Picjavard/Katamaran_Model/README.md

# Радиоуправляемая Модель Катамарана/Лодки

> ⚠️ **Внимание!** Это описание проекта все еще редактируется и может измениться. По возникающим вопросам обращаться на почту picjavard@yandex.ru

**Проект лаборатории "Электроника", ВДЦ "Океан"**  
*Создано школьниками под руководством преподавателя*

Фото готовых моделей
[`Фото собранных моделей`](Фото/)

Проект по созданию радиоуправляемой модели катамарана (или лодки) с воздушным винтом и рулем. Модель построена школьниками на смене в ВДЦ "Океан" из доступных материалов (пеноплекс, ПВХ) с использованием базовых навыков пайки и конструирования.

**Особенности проекта:**
*   Самодельный корпус из пеноплекса
*   Воздушный движитель (пропеллер) и воздушный руль
*   Электроника на макетной плате с удобными коннекторами
*   Защита от брызг подручными средствами
*   Адаптивность: гонки можно провести как на воде, так и на суше!

## 📦 Необходимые Компоненты и Материалы
| Категория | Компонент/Материал | Кол-во | Примечание/Ссылка\* |
|---|---|---|---|
| **Корпус** | Пеноплекс (толщина 20-50мм), лист ~A3 | 1-2 | [Основа для поплавков/корпуса](https://www.vseinstrumenti.ru/product/ekstrudirovannyj-penopolistirol-penoplex-komfort-50x585x1185-mm-v-upakovke-7-sht-tu0-0001954-7207370/) |
| | Лист ПВХ (толщина 2-3мм), размер под корпус | 1 | [Палуба для крепления механизмов и электроники](https://www.ozon.ru/product/pvh-paneli-a3-5-shtuk-dlya-modelirovaniya-i-rukodeliya-plastik-listovoy-dlya-hobbi-i-tvorchestva-1718241610/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) |
| | Мачта-крепление двигателя | 1 | [Луч от рамы квадрокоптера модели F450](https://aliexpress.ru/item/961013343.html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)
| **Движитель** | Бесколлекторный мotor (например, 2212 1000KV) | 1 | [При выборе мотора, подбор пропеллера обезателен](https://www.ozon.ru/product/besshchetochnyy-dvigatel-a2212-13t-1000kv-s-testerom-servoprivodov-3-rezhima-servo-tester-2379004382/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) |
| | Пропеллер 12x6 или 10x4.7 (пластиковый) | 1 | Радиус ~12см, лучше брать в комплекте с мотором |
| | ESC (Electronic Speed Controller) 20-30A с BEC 5V/3A | 1 | |
| **Управление** | Сервомашинка SG90 или аналог (9г, 1.5-2.5кг\*см) | 1 | [Для воздушного руля](https://www.ozon.ru/product/servoprivod-mg90s-s-metallicheskim-reduktorom-tower-pro-2163148633/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) |
| | Воздушный руль (3D печать/пластик) | 1 | Файлы STL в папке `3D_Models/` |
| | Кронштейн мотора (3D печать/металл) | 1 | Файлы STL в папке `3D_Models/` |
| **Радио** | Приемник FS-IA6B (Flysky) или совместимый 6-канальный | 1 | [Работает с пультами FS-i6, FS-i6X, в комплекте с пультом](https://www.ozon.ru/product/flysky-radioapparatura-2-4ghz-fs-i6-s-priemnikom-fs-ia6b-2457042246/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) |
| | Пульт ДУ Flysky FS-i6 / FS-i6X | 1 | |
| **Питание** | LiPo аккумулятор 3S (11.1V) 1000-2200mAh | 1 | [Любой Li-Po 3S (11.2V) емкостью около 2000mAh](https://www.ozon.ru/product/akkumulyator-vant-lipo-11-1v-2200mah-30c-razem-t-plug-dlya-radioupravlyaemyh-vertoletov-1208943884/) |
| | Зарядное устройство для LiPo 3S | 1 | [IMAX B6 с блоком питания](https://www.ozon.ru/product/zaryadnoe-ustroystvo-imax-b6-80w-blok-pitaniya-dlya-litiy-ionnyy-li-ion-lipo-life-nicd-i-1558732502/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) |
| **Электроника** | Макетная плата (Perfboard/Stripboard) | 1 | [Двусторонняя, 5х7см](https://www.ozon.ru/product/pechatnaya-maketnaya-plata-5x7-sm-dvuhstoronnyaya-dlya-payki-gsmin-pcb1-komplekt-4-sht-zelenyy-1220449217/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) |
| | Быстрые зажимные коннекторы (для АКБ и ESC) | 2 пары | [Для пайки на печатную плату](https://www.vseinstrumenti.ru/product/klemmnik-keen-side-kse-308v-2-54-02p-upakovka-50-sht-131610-17217041/) |
| | Штыревые разъемы: "Мама" (гнезда), "Папа" (пины) | 1 набор| Для подключения приемника, серво, ESC к макетке. [Пины](https://www.ozon.ru/product/shtyrevye-odnoryadnye-razemy-na-platu-papa-pls-40-pryamye-40-pin-2-54-mm-10-shtuk-pld-razem-1046480730/), [гнезда](https://www.ozon.ru/product/shtyrevye-odnoryadnye-razemy-na-platu-mama-pbs-40-40-pin-2-54-mm-10-shtuk-pld-razem-dlya-proektov-1051231516/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) |
| | Кнопка тактовая или с фиксацией положения | 1 | [Для биндинга приемника](https://www.chipdip.ru/product/kls7-p8.5x8.5-1-pb22e09-knopka-miniatyurnaya-s-fiksatsiey-63619) |
| | Понижающий DC-DC конвертер | 1 | [Для понижения с 11.1V до 5v для приемника, серво](https://www.ozon.ru/product/ponizhayushchiy-dc-dc-preobrazovatel-mini560-5v-613793193/) |
| **Прочее** | Провода (силовые и сигнальные) | - | [Сечение ~0.75-1.5мм² (силовые), ~0.2-0.3мм² (сигн.)](https://www.chipdip.ru/product/mgtf-0.07-kv-mm-provod-montazhnyy-za-1m-2-6) |
| | Припой, флюс, термоусадка | - | Лучший [припой](https://www.ozon.ru/product/pripoy-63-37-s-flyusom-kaina-cf-10-100gr-0-8mm-728539351/) |
| | Монтажная полиуретановая пена (клей) | 1 балл.| [Для склейки корпуса](https://www.chipdip.ru/product/kley-pena-universalnyy-konstruktsionnyy-prof-kudo-8020692669) |
| | Герметик силиконовый (аквариумный) | 1 туба | [Для герметизации швов](https://www.vseinstrumenti.ru/product/germetik-dlya-akvariumov-i-vitrin-kudo-prozrachnyj-280-ml-ksk-200-1370186/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:Благовещенск&yclid=178384485049958399) |
| | Универсальный клей | 1 шт.  | [Для склейки корпуса и палубы](https://www.vseinstrumenti.ru/product/universalnyj-polimernyj-klej-russkij-titan-morozoustojchivyj-0-5-l-4607133681104-2245606/) |
| | Термоклей | 1 шт.  | Термоклеея мало не бывает, может пригодиться |
| | Двусторонний скотч, стяжки, винты M2-M3, гайки | - | |
| | Балласт (свинцовые грузики, болты) | - | Для балансировки корпуса |
| **Инструменты** | Паяльник + подставка | 1 | |
| | Кусачки, пинцет, отвертки | 1 набор| |
| | Канцелярский нож, ножовка/лобзик (для ПВХ) | 1 | |
| | Линейка, угольник, карандаш | 1 | |
| | Шприц/пистолет для герметика/клея | 1 | |
| | Защитные перчатки, очки | - | |

*\*ссылки указаны для примера, все компоненты можно найти и заказать в любых других магазинах/маркетплейсах*

## 🔧 Схемы Подключения
*   [`Схемы/Модель_платы.png`](Схемы/Модель_платы.png) - Рендер 3D-модели платы.
*   [`Схемы/3D_Модель_платы.obj`](Схемы/3D_Модель_платы.obj) - 3D-модель платы.
*   [`Схемы/3D_Модель_платы_Материалы.mtl`](Схемы/3D_Модель_платы_Материалы.mtl) - Материалы для 3D-модели платы(цвет).
*   [`Схемы/Принципиальная_схема.png`](Схемы/Принципиальная_схема.png) - Графическая схема подключений.
*   [`Схемы/Gerber_RC-Plate1_2025-08-21(Для_заказа_печати).zip`](Схемы/Gerber_RC-Plate1_2025-08-21(Для_заказа_печати).zip) - Архив для заказа платы на изготовление, например на https://jlcpcb.com/.
*   [`Схемы/ProPrj_RC-Plate_2025-08-21.epro`](Схемы/ProPrj_RC-Plate_2025-08-21.epro) - Файл проекта платы в EasyEDA Pro.
    
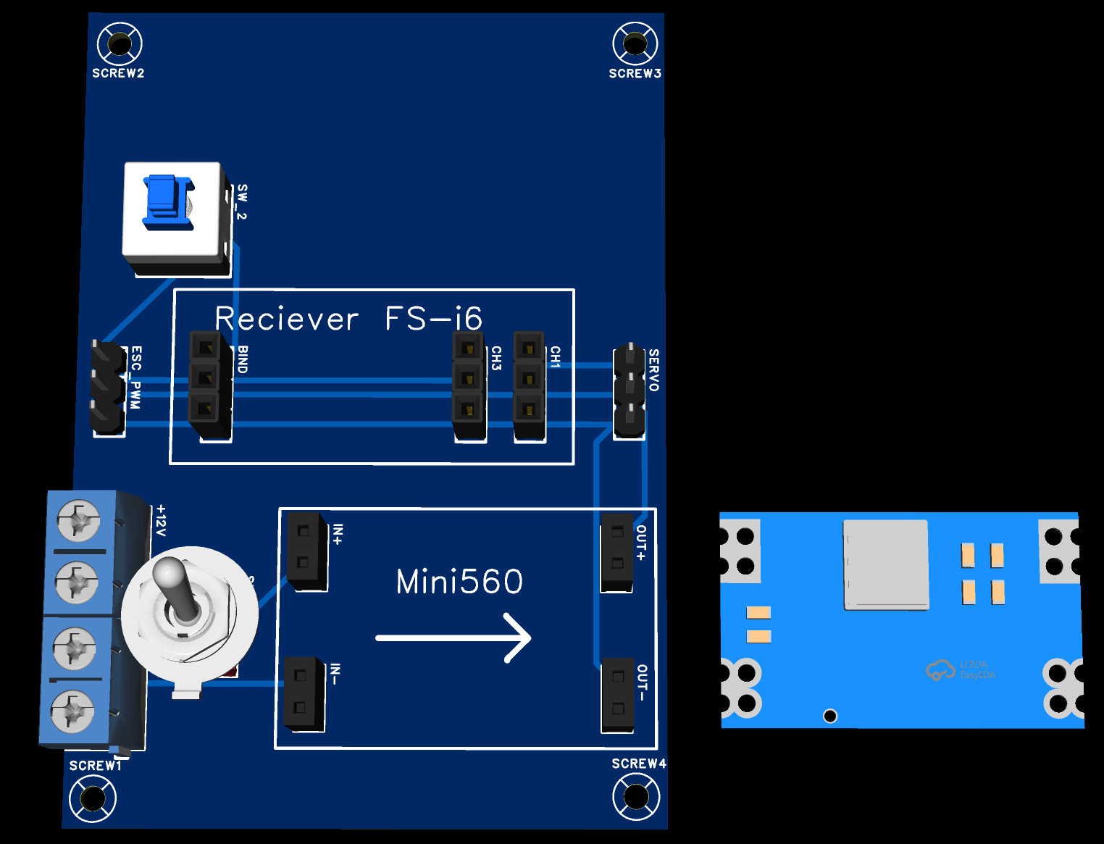
[picture p1: Схемы/Модель_платы.png]
Схема подключения электроники
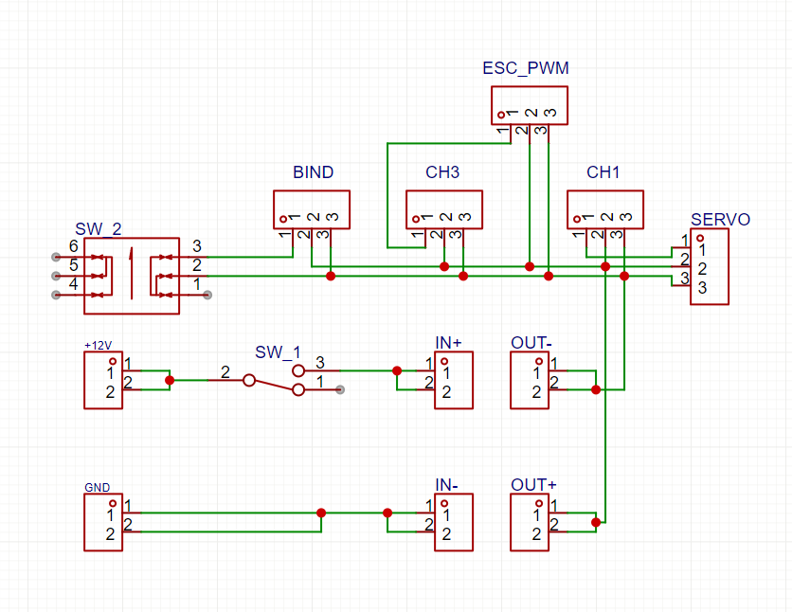
[picture p2: Схемы/Принципиальная_схема.png]
Схема подключения электроники 2
	
    
	*Пояснение:*
1.  Аккумулятор 3S подключается к быстрым зажимам на макетке ("+12V" и "GND").
2.  ESC подключается к тем же зажимам ("+12V" и "GND") и к ШИМ-выходу "ESC_PWM" на макетке.
3.  Сервомашинка подключается к ШИМ-выходу "SERVO" на макетке.
4.  Приемник вставляется в гнезда типа "Мама" на макетке (BIND, CH3 и CH1).
5.  Кнопка биндинга подключается между сигнальной ногой приемника "BIND" и землей "GND" ("SW_2").
6.  DC-DC конвертер (Mini560) подключается к входу от АКБ, выход 5V/3A подается на питание приемника/макетки ("IN+", "IN-","OUT+" и "OUT-").
7.  В разрыв питания от аккумуляторо следует поставить тумблер для удобного вкл./выкл. системы ("SW_1")

## ⚙️ 3D Модели (STL файлы)
*   [`Carpet Cruiser Remix`](https://www.thingiverse.com/thing:7124142)  - Ссылка на проект на Thingiverse.
*   [`Carpet Cruiser`](https://www.thingiverse.com/thing:6962726)  - Ссылка на оригинальный проект (для модели меньшего размера).

**Рекомендации по печати:**
*   Материал: PLA или PETG (достаточно прочно).
*   Заполнение: 20-40%.

## 🛠 Этапы Создания Модели (Кратко)
1.  **Проектирование и Корпус:**
    *   Разметка и вырезка корпуса/поплавков из пеноплекса.
    *   Склейка деталей корпуса монтажной пеной (если корпус сборный).
    *   Герметизация швов аквариумным герметиком.
    *   Вырезка палубы из ПВХ.
    *   **Тест плавучести корпуса!** Добавление балласта.
2.  **Механизмы:**
    *   Сборка двигательной установки (мотор + мачта + пропеллер + адаптер).
    *   Сборка рулевого механизма (серво + рама + тяга(нитки или проволока) + воздушный руль + штифт).
    *   Крепление механизмов к палубе ПВХ винтами.
3.  **Электроника:**
    *   Пайка компонентов на макетную плату (разъемы, кнопка биндинга, провода и т.п.).
    *   Пайка силовых коннекторов (аккумулятора, ESC).
    *   Подключение ESC, сервомашинки, mini560 и приемника к макетке.
    *   **Сухое тестирование!** (Биндинг пульта, проверка мотора без пропеллера, проверка руля).
4.  **Сборка и Защита:**
    *   Крепление макетной платы, ESC, приемника, аккумулятора к палубе (двусторонний скотч, стяжки, винты).
    *   Изготовление кожухов/защиты от брызг из ПВХ/пеноплекса.
    *   Крепление палубы с механикой и электроникой к корпусу универсальным клеем.
    *   Усиление герметизации стыков и защитных кожухов.
5.  **Испытания и Соревнования:**
    *   **Сухопутные испытания с пропеллером!** (Осторожно!) Корпус можно обклеить скотчем и протестировать на скользкой поверхности (паркет/пвх/плитка) или перед склейкой палубы протестировать без корпуса на ковре/снеге/льду/плитке.
    *   Водные испытания (проверка плавучести, управляемости, герметичности).
    *   **СОРЕВНОВАНИЯ:** На воде или на суше.

## ⚠️ Проблемы и Решения (Из нашего опыта)
*   **Проблема:** Электроника намокает от брызг.  
    **Решение:** Тщательная герметизация *всех* стыков кожухов герметиком. Защита разъемов термоусадкой со клеем или специальной смазкой. Размещение электроники как можно выше. Использовать "шайбочки" из термоусадки на проводах перед вводом в кожух.
*   **Проблема:** Модель кренится на бок или задирает нос.  
    **Решение:** Тщательная балансировка балластом во время **теста плавучести голого корпуса**. Центр тяжести ~1/3 длины от кормы. Вес электроники на палубе распределять равномерно.
*   **Проблема:** Слабый ход или перегрев ESC.  
    **Решение:** Проверить соответствие ESC и мотора. Убедиться в надежности *всех* силовых паяных соединений и контактов. Не использовать пропеллер больше рекомендованного.
*   **Проблема:** Шторм! Невозможно провести гонки на воде.  
    **Решение:** Импровизация! Гонки на гладком полу (сцене) с полосками скотча на днище для лучшего сцепления. Сделать трассу из конусов или разметить коридор. Отличный вариант Б!
*   **Проблема:** Пеноплекс крошится при резке.  
    **Решение:** Использовать очень острый нож. Резать медленно, без излишнего давления. Резать лучше взрослому.

## 💡 Советы Юным Инженерам
*   **Тестируй рано и часто:** Плавучесть корпуса *до* установки электроники! Электронику на столе *до* установки на модель!
*   **Не экономь на герметизации:** Вода найдет малейшую щель. Лучше переборщить.
*   **Баланс - это важно:** Потрать время на балластировку. Неустойчивая лодка не будет хорошо управляться.
*   **Думай о ремонте:** Делай так, чтобы можно было добраться до электроники для починки (напр., не заливай ее намертво герметиком).
*   **Импровизируй:** Нет нужного материала? Ищи замену! Нельзя на воду? Гоняй на суше! Инженерное решение - это часто выход за рамки плана.

## 👨‍🏫 Для Преподавателей
*   **Файлы:** `Документы/КТП_СилаМоря_Электроника.XLSX` - План 12 занятий.
*   **Безопасность:** Резку пеноплекса, работу с монтажной пеной и основную пайку силовых цепей выполняет преподаватель. Строгий контроль при работе с паяльником и LiPo аккумуляторами. Обязательны перчатки и очки при работе с пеной и герметиком.
*   **Адаптация:** Проект хорошо масштабируется. Можно упростить (готовые корпуса, проще электронику) или усложнить (датчики, телеметрия, другой дизайн корпуса).
*   **Ключевые навыки:** Работа с материалами (пеноплекс, ПВХ), пайка, понимание основ схемотехники, механики, плавучести, решение практических задач, работа в команде, импровизация.
*   **"Океанский" опыт:** Успешно реализован в условиях смены ВДЦ "Океан" с ограниченным временем. Адаптирован под отсутствие доступа к воде в финале.

## 👏 Авторы и Благодарности
*   **Участники лаборатории "Электроника"** ВДЦ "Океан", Смена "Сила моря", 2025.
*   **Руководитель:** Демьяненко Александр Евгеньевич.

---

**Желаю удачи в создании своих удивительных моделей!** 🚤💨
