Picjavard/Katamaran_Model/Фото/README.md

WhatsApp Image 2025-08-19 at 10 23 10
WhatsApp Image 2025-08-19 at 10 23 10 (1)
WhatsApp Image 2025-08-19 at 10 23 07

WhatsApp Image 2025-08-19 at 10 23 08
WhatsApp Image 2025-08-19 at 10 23 09
WhatsApp Image 2025-08-19 at 10 23 09 (1)
