Picjavard/Katamaran_Model/Фото/Screenshot_63.png

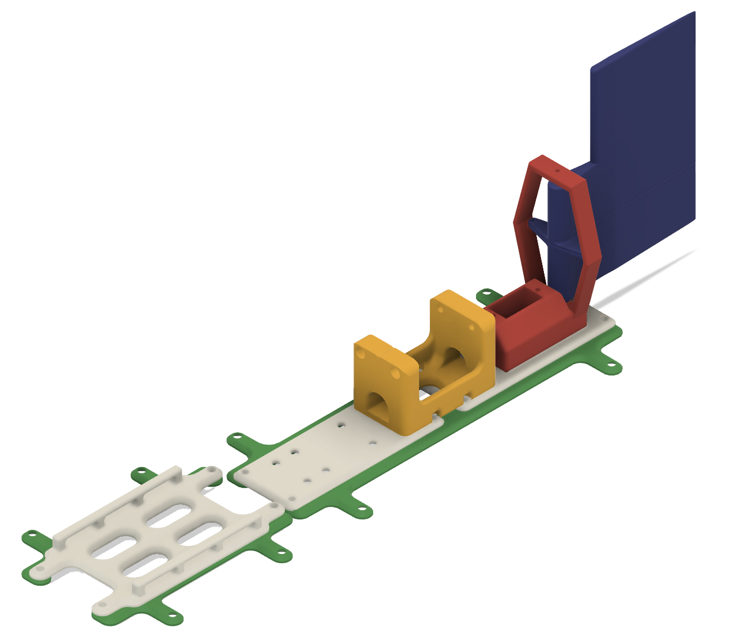
Фото/Screenshot_63.png
