Picjavard/Katamaran_Model/Фото/WhatsApp Image 2025-08-19 at 10.23.08.jpeg

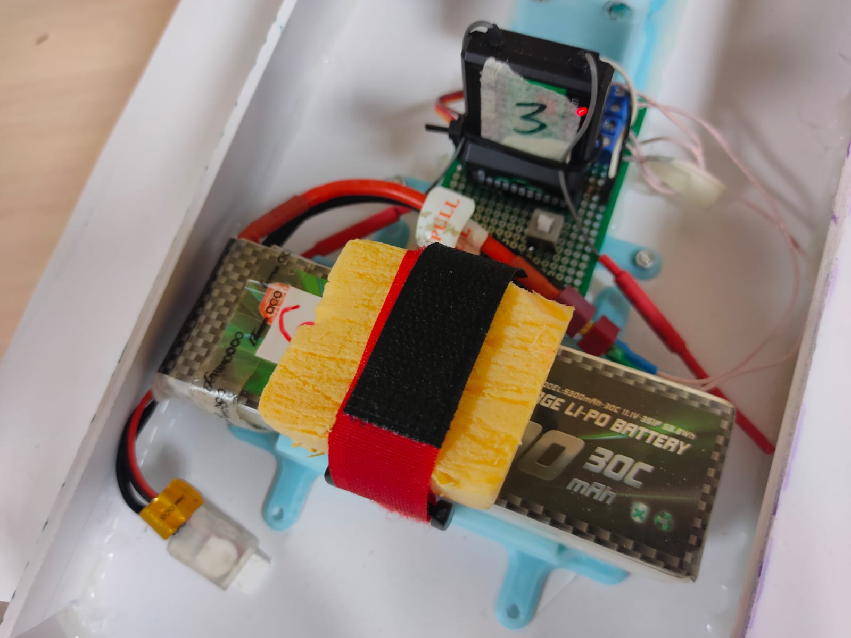
Фото/WhatsApp Image 2025-08-19 at 10.23.08.jpeg
