Picjavard/Katamaran_Model/(list of files, drawings)

Other design files:
Схемы/ProPrj_RC-Plate_2025-08-21.epro
