Picjavard/Katamaran_Model/(commit log)

2025-08-21 Update Project
    [ProPrj_RC-Plate_2025-08-21.epro]
2025-08-22 Update project (release)
    [КТП_СилаМоря_Электроника.XLSX]
